slabua/I2CSHIMForPico/README.md

# I2C SHIM for Pico
###### tags: `SLBLabs` `SLB Labs` `I2CSHIMForPico` `Raspberry Pi` `RaspberryPi` `Raspberry` `Pi` `Pico` `RaspberryPiPico` `RP2040` `MicroPython` `CircuitPython` `Arduino` `C/C++`

## Quickly add I2C connectors to the Pico
I2C SHIM for Pico is a simple way to provide easy access to the I2C bus 0 and 1 on a Raspberry Pi Pico via two Qw/ST connectors.

### Product Page
Order at:
- [https://www.tindie.com/products/slblabs/i2c-shim-for-pico/](https://www.tindie.com/products/slblabs/i2c-shim-for-pico/)
- [Coming Soon]

I2CSHIMForPico-R1.0

### Features

- **Dual Qwiic/StemmaQT connectors**
  - Connector for I2C0 on GPIO 0 (SDA) and 1 (SCL).
  - Connector for I2C1 on GPIO 2 (SDA) and 3 (SCL).
- **3V3 Power line**
  - Each connector is powered by the Pico regulated 3V3 line for a stable power supply.
- **Staggered header pads**
  - Header pads offset from the center line by 5 mils either direction.
  - Allows for a snug press-fit on the back of the Pico.
  - ※ Soldering is still advised.

I2CSHIMForPico-R1.0

[^Top](#Top)

---
## I2C SHIM for Pico Rev 1.0 Overview

|Front|Back|
|:-:|:-:|
|Front|Back|
|Panel Front|Panel Back|
|Panel Front|Panel Back|

### Schematic

Schematic

[^Top](#Top)
