slabua/I2CSHIMForPico/(commit log)

2025-05-22 Add Rev 1.0 files
    [I2CSHIMForPico.kicad_pcb, I2CSHIMForPico.kicad_sch]
2025-05-22 Add BOM and CPL files
    [BOM-I2CShimForPico-panel.csv, BOM-I2CShimForPico.csv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]
2025-05-22 Uniform file names
    [BOM-I2CSHIMForPico-panel.csv, BOM-I2CSHIMForPico.csv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]
2025-05-23 First commit of Rev 1.1
    [I2CSHIMForPico.kicad_pcb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]
2025-05-23 Update to PCB, Panel, and JLCPCB production files
    [I2CSHIMForPico.kicad_pcb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]
2025-05-24 Improved panelisation
    [CPL-I2CSHIMForPico-panel.csv]
2025-05-24 Minor update to Qw/ST connectors position
    [I2CSHIMForPico.kicad_pcb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]
2025-05-25 Add optional pull-up resistor network
    [BOM-I2CSHIMForPico-panel.csv, BOM-I2CSHIMForPico.csv, I2CSHIMForPico-panel.kicad_pcb, I2CSHIMForPico.kicad_pcb, I2CSHIMForPico.kicad_sch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]
2025-05-25 Move pull-up pad to top layer
    [BOM-I2CSHIMForPico-panel.csv, BOM-I2CSHIMForPico.csv, I2CSHIMForPico-panel.kicad_pcb, I2CSHIMForPico.kicad_pcb, I2CSHIMForPico.kicad_sch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]
2025-05-26 Minor edit to the back silkscreen
    [I2CSHIMForPico.kicad_pcb]
2025-05-26 Update production files
    [I2CSHIMForPico.kicad_pcb]
2025-05-26 Minor edit to front copper
    [I2CSHIMForPico.kicad_pcb]
2025-05-27 Change resistor network footprint to concave
    [BOM-I2CSHIMForPico.csv, I2CSHIMForPico.kicad_pcb, I2CSHIMForPico.kicad_sch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]
2025-05-27 Update panel
    [BOM-I2CSHIMForPico-panel.csv, I2CSHIMForPico-panel.kicad_pcb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]
2025-05-30 Minor update to font thickness
    [I2CSHIMForPico.kicad_pcb]
2025-06-04 Update files for Rev 1.1
    [I2CSHIMForPico-panel.kicad_pcb, I2CSHIMForPico.kicad_pcb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]
